MST-MRDT/Motor-Controller/Documentation/2020 BOM/MotorController_Hardware_2020_Rev1_BOM.csv

Id | Designator | Package | Quantity | Designation | Supplier and ref
1 | G*** | Zenith_Logo_30mm | 1 | LOGO
2 | G*** | Wifi_Power_Net_5mmX6mm | 1 | LOGO
3 | REF**,REF**,REF**,REF** | 4_40_Hole_Corner | 4 | 4_40_Hole
4 | U1 | DRV8301 | 1 | DRV8301 | https://www.digikey.com/products/en?keywords=296-29433-1-ND | https://www.newark.com/texas-instruments/drv8301dcar/motor-driver-3ph-56htssop/dp/28AH2478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
5 | C1,C4,C10,C13,C15,C18,C19,C20,C21,C33,C34,C35,C40,C41,C42,C43,C44 | C_0603_1608Metric_Pad1.05x0.95mm_HandSolder | 17 | 0.1u | https://www.newark.com/avx/06035c104jat2a/ceramic-capacitor-0-1uf-50v-x7r/dp/60R6235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
6 | C2,C8 | C_0603_1608Metric_Pad1.05x0.95mm_HandSolder | 2 | 4.7u | https://www.digikey.com/products/en?keywords=490-10751-1-ND
7 | C3,C26,C27 | C_0603_1608Metric_Pad1.05x0.95mm_HandSolder | 3 | 1u | https://www.newark.com/avx/06035c104jat2a/ceramic-capacitor-0-1uf-50v-x7r/dp/60R6235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
8 | C5,C7,C9,C11 | CP_Radial_D12.5mm_P5.00mm | 4 | 470u | https://www.newark.com/panasonic/eca-1jhg471/aluminum-electrolytic-capacitor/dp/96K9189
9 | C6 | CP_Radial_D6.3mm_P2.50mm | 1 | 47u | https://www.newark.com/panasonic/eca-1hm470/aluminum-electrolytic-capacitor/dp/96K9182
10 | C12,C14 | C_0603_1608Metric_Pad1.05x0.95mm_HandSolder | 2 | 2200p | https://www.newark.com/kemet/c0603c222k5ractu/ceramic-capacitor-2200pf-50v-x7r/dp/64K2852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
11 | C16 | C_0603_1608Metric_Pad1.05x0.95mm_HandSolder | 1 | 0.01u | https://www.newark.com/tdk/cga3e2x7r1h103k080ae/cap-0-01-f-50v-10-x7r-0603/dp/68AC4563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
12 | C17 | C_0603_1608Metric_Pad1.05x0.95mm_HandSolder | 1 | .022u | https://www.newark.com/vishay/vj0603y223jxacw1bc/cap-0-022-f-50v-5-x7r-0603/dp/62AC8374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
13 | C22 | C_0603_1608Metric_Pad1.05x0.95mm_HandSolder | 1 | 0.015u | https://www.newark.com/vishay/vj0603y153kxacw1bc/cap-0-015-f-50v-10-x7r-0603/dp/62AC8368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
14 | C23 | C_0603_1608Metric_Pad1.05x0.95mm_HandSolder | 1 | 120p | https://www.newark.com/avx/06035a121jat2a/ceramic-capacitor-120pf-50v-c0g/dp/17C6469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
15 | C24 | C_0603_1608Metric_Pad1.05x0.95mm_HandSolder | 1 | 6800p | https://www.newark.com/kemet/c0603c682j5gactu/cap-mlcc-c0g-6800pf-50v-0603/dp/72M7462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
16 | C25,C30,C31,C32 | C_0603_1608Metric_Pad1.05x0.95mm_HandSolder | 4 | 2.2u | https://www.newark.com/taiyo-yuden/umk107bbj225ka-t/capacitor-mlcc-0603-50v-x5r-2/dp/08AH2222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
17 | C28,C29 | C_0603_1608Metric_Pad1.05x0.95mm_HandSolder | 2 | 1000p | https://www.newark.com/avx/06035c102kat2a/ceramic-capacitor-1000pf-50v-x7r/dp/09J2480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
18 | C36 | C_0603_1608Metric_Pad1.05x0.95mm_HandSolder | 1 | .015 uF | https://www.newark.com/vishay/vj0603y153kxacw1bc/cap-0-015-f-50v-10-x7r-0603/dp/62AC8368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
19 | Conn1 | MOLEX_SL_05_Horizontal | 1 | Molex_SL_05
20 | Conn3 | Anderson_2_Horizontal_Stacked | 1 | AndersonPP
21 | Conn4 | Anderson_1_Horizontal | 1 | SH_A_M1_PP
22 | Conn5 | Anderson_1_Horizontal | 1 | SH_B_M1_PP
23 | Conn6 | Anderson_1_Horizontal | 1 | SH_C_M1_PP
24 | D2,D3,D4,D5 | L_0603_1608Metric_Pad1.05x0.95mm_HandSolder | 4 | LED | https://www.newark.com/vishay/vlmg1300-gs08/led-yellow-green-571nm/dp/76T8664?st=0603%20green%20LED
25 | D7,D8,D9,D10,D11,D12 | D_SOD-123 | 6 | 15V | https://www.newark.com/on-semiconductor/mmsz4684t1g/zener-diode-500mw-3-3v-sod-123/dp/45J1578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
26 | L1 | DR74_330_R | 1 | 33u | https://www.newark.com/eaton-coiltronics/dr74-330-r/inductor-shielded-33uh-1-73a-smd/dp/52K7577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
27 | Q1,Q2 | SOT-23_Handsoldering | 2 | Q_PMOS_DGS | https://www.digikey.com/products/en?keywords=SSM3J338RLFCT-ND
28 | Q4,Q5,Q6,Q7,Q8,Q9 | TO-220-3_Horizontal_Reversed_NoHole | 6 | FQP30N06L | https://www.digikey.com/products/en?keywords=FQP30N06L
29 | R1,R2,R3,R5 | R_0603_1608Metric_Pad1.05x0.95mm_HandSolder | 4 | 10k | https://www.newark.com/multicomp/mcwr06x1002ftl/surface-mount-thick-film-resistor/dp/94X1379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
30 | R4 | R_0603_1608Metric_Pad1.05x0.95mm_HandSolder | 1 | 31.6k | https://www.newark.com/vishay/crcw040231k6fked/res-thick-film-31k6-1-0-063w-0402/dp/52K6966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
31 | R6,R8 | R_0603_1608Metric_Pad1.05x0.95mm_HandSolder | 2 | 1k | https://www.newark.com/vishay/crcw06031k00fkea/res-thick-film-1k-1-0-1w-0603/dp/52K8016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
32 | R7 | R_0603_1608Metric_Pad1.05x0.95mm_HandSolder | 1 | 100 | https://www.newark.com/yageo/rc0603fr-07100rl/res-thick-film-100r-1-0-1w-0603/dp/68R0052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
33 | R9 | R_0603_1608Metric_Pad1.05x0.95mm_HandSolder | 1 | 510 | https://www.newark.com/vishay/crcw0603510rfkea/res-thick-film-510r-1-0-1w-0603/dp/52K8597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
34 | R10,R13 | R_0603_1608Metric_Pad1.05x0.95mm_HandSolder | 2 | 500 | https://www.newark.com/vishay/crcw0603510rfkea/res-thick-film-510r-1-0-1w-0603/dp/52K8597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
35 | R11,R12 | R_0603_1608Metric_Pad1.05x0.95mm_HandSolder | 2 | 56 | https://www.newark.com/vishay/crcw060356r0jnea/res-thick-film-56r-5-0-1w-0603/dp/59M6825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
36 | R14 | R_1206_3216Metric_Pad1.42x1.75mm_HandSolder | 1 | 3.3 | https://www.newark.com/vishay/crcw12063r30jnea/res-thick-film-3r3-5-0-25w-1206/dp/59M6979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
37 | R15,R30,R32,R34 | R_0603_1608Metric_Pad1.05x0.95mm_HandSolder | 4 | 46.4k | https://www.digikey.com/product-detail/en/yageo/RT0603BRD0746K4L/YAG1665CT-ND/5139113
38 | R16,R31,R33,R35 | R_0603_1608Metric_Pad1.05x0.95mm_HandSolder | 4 | 4.99k | https://www.digikey.com/product-detail/en/yageo/RT0603BRD074K99L/YAG1678CT-ND/5139126
39 | R18 | R_0603_1608Metric_Pad1.05x0.95mm_HandSolder | 1 | 205k | https://www.newark.com/vishay/crcw0603205kfkea/res-thick-film-205k-1-0-1w-0603/dp/52K8275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
40 | R19 | R_0603_1608Metric_Pad1.05x0.95mm_HandSolder | 1 | 150k | https://www.newark.com/panasonic/erj-3ekf1503v/res-thick-film-150k-1-0-1w-0603/dp/64R5321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
41 | R20 | R_0603_1608Metric_Pad1.05x0.95mm_HandSolder | 1 | 16.2k | https://www.newark.com/panasonic/erj-3ekf1622v/res-thick-film-16k2-1-0-1w-0603/dp/65T8345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
42 | R22,R23,R24,R25,R26,R27 | R_0603_1608Metric_Pad1.05x0.95mm_HandSolder | 6 | 10 | https://www.newark.com/vishay/crcw060310r0fkeahp/res-aec-q200-10r-1-0-25w-0603/dp/65AC3377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
43 | R28,R29 | R_1206_3216Metric_Pad1.42x1.75mm_HandSolder | 2 | 0.001 | https://www.digikey.com/product-detail/en/stackpole-electronics-inc/CSNL1206FT1L00/CSNL1206FT1L00CT-ND/1788120
44 | U2 | NUP4201MR6 | 1 | NUP4201MR6 | https://www.digikey.com/product-detail/en/diodes-incorporated/D5V0P4UR6SO-7/D5V0P4UR6SO-7DICT-ND/6052574
45 | U4 | SOIC_16_3.9x9.9mm_Pitch1.27mm | 1 | MAX_3232 | https://www.digikey.com/product-detail/en/texas-instruments/MAX3232CDR/296-13094-1-ND/484464
46 | +3V3,GHB_M1,GHC_M1,GLA_M1,GLB_M1,GLC_M1,PVDD_M1,SHA_M1,SHB_M1,SHC_M1 | Via_.6mm | 10 | TEST
47 | GHA_M1 | Via_.6mm | 1 | tp
48 | D1 | D_0603_1608Metric_Pad1.05x0.95mm_HandSolder | 1 | D_Zener
49 | R17,R21 | R_0603_1608Metric_Pad1.05x0.95mm_HandSolder | 2 | 0 | https://www.newark.com/vishay/crcw06030000z0eahp/res-thick-film-0r-0-25w-0603/dp/68R2987
50 | U3 | F28027M_THT_TOP | 1 | F28027M
51 | R36 | R_0603_1608Metric_Pad1.05x0.95mm_HandSolder | 1 | 1000 | https://www.newark.com/vishay/crcw06031k00fkea/surface-mount-thick-film-resistor/dp/61M5328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
