MST-MRDT/Motor-Controller/MotorController_Hardware/MotorController_Hardware.kicad_pcb

## KiCad design MotorController_Hardware/MotorController_Hardware.kicad_pcb (2019-11-07)

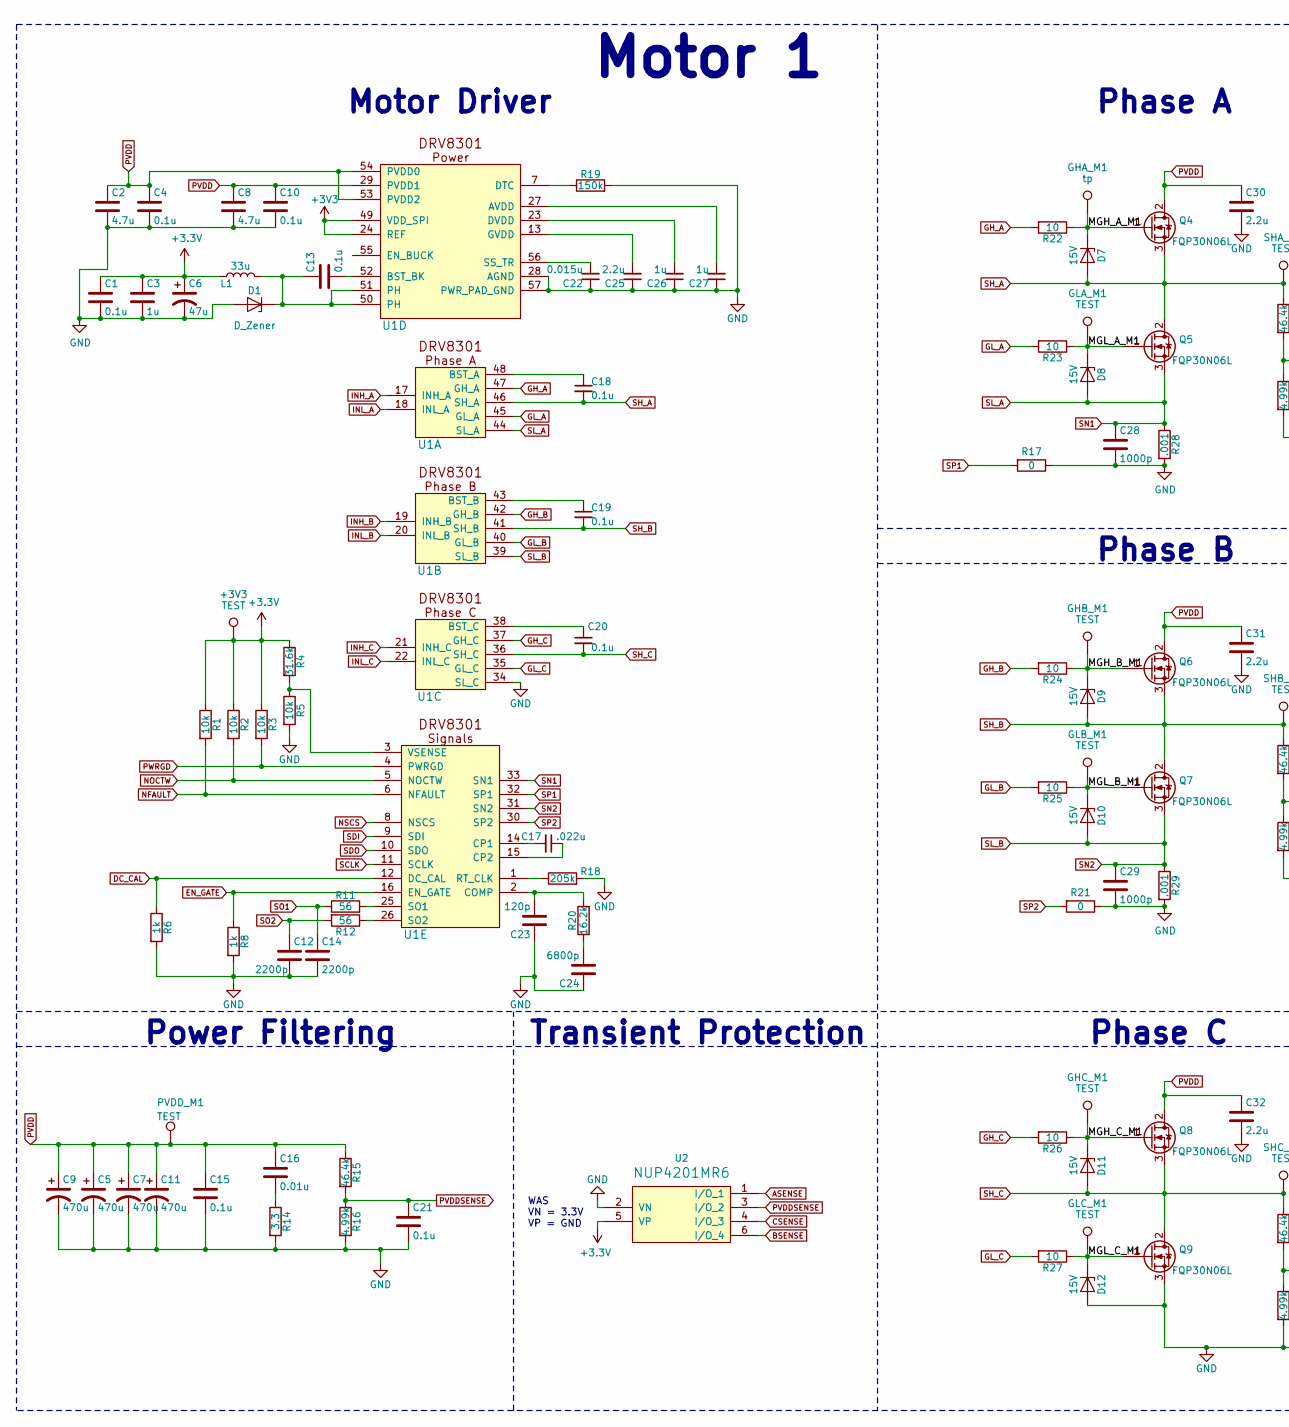
[picture p1: schematic MotorController_Hardware.sch, part in row 1, column 1]

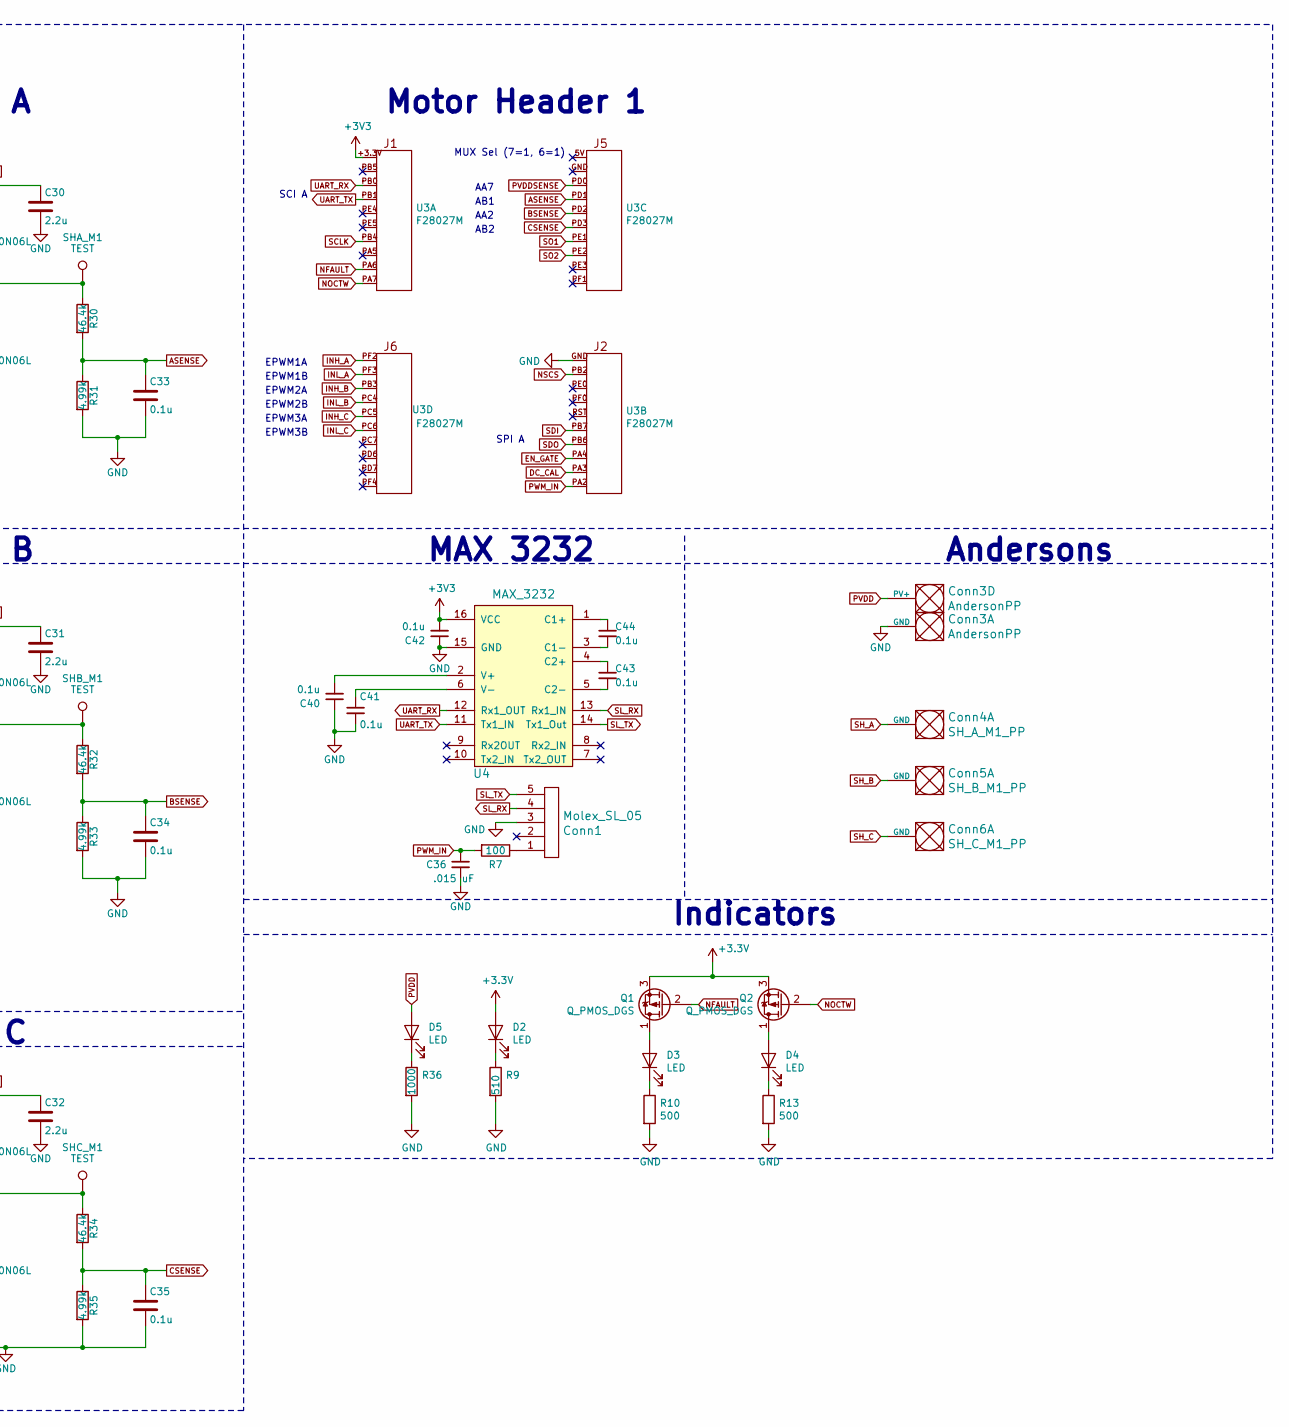
[picture p2: schematic MotorController_Hardware.sch, part in row 1, column 2]

Parts:
+3V3: TEST; Via_.6mm
C1, C4, C10, C13, C15, C18, C19, C20, C21, C33, C34, C35, C40, C41, C42, C43, C44: 0.1u; C_0603_1608Metric_Pad1.05x0.95mm_HandSolder
C2, C8: 4.7u; C_0603_1608Metric_Pad1.05x0.95mm_HandSolder
C3, C26, C27: 1u; C_0603_1608Metric_Pad1.05x0.95mm_HandSolder
C5, C7, C9, C11: 470u; CP_Radial_D12.5mm_P5.00mm
C6: 47u; CP_Radial_D6.3mm_P2.50mm
C12, C14: 2200p; C_0603_1608Metric_Pad1.05x0.95mm_HandSolder
C16: 0.01u; C_0603_1608Metric_Pad1.05x0.95mm_HandSolder
C17: .022u; C_0603_1608Metric_Pad1.05x0.95mm_HandSolder
C22: 0.015u; C_0603_1608Metric_Pad1.05x0.95mm_HandSolder
C23: 120p; C_0603_1608Metric_Pad1.05x0.95mm_HandSolder
C24: 6800p; C_0603_1608Metric_Pad1.05x0.95mm_HandSolder
C25, C30, C31, C32: 2.2u; C_0603_1608Metric_Pad1.05x0.95mm_HandSolder
C28, C29: 1000p; C_0603_1608Metric_Pad1.05x0.95mm_HandSolder
C36: .015 uF; C_0603_1608Metric_Pad1.05x0.95mm_HandSolder
Conn1: Molex_SL_05; MOLEX_SL_05_Horizontal
Conn3: AndersonPP; Anderson_2_Horizontal_Stacked
Conn4: SH_A_M1_PP; Anderson_1_Horizontal
Conn5: SH_B_M1_PP; Anderson_1_Horizontal
Conn6: SH_C_M1_PP; Anderson_1_Horizontal
D1: D_Zener; D_0603_1608Metric_Pad1.05x0.95mm_HandSolder
D2, D3, D4, D5: LED; L_0603_1608Metric_Pad1.05x0.95mm_HandSolder
D7, D8, D9, D10, D11, D12: 15V; D_SOD-123
GHA_M1: tp; Via_.6mm
GHB_M1: TEST; Via_.6mm
GHC_M1: TEST; Via_.6mm
GLA_M1: TEST; Via_.6mm
GLB_M1: TEST; Via_.6mm
GLC_M1: TEST; Via_.6mm
L1: 33u; DR74_330_R
PVDD_M1: TEST; Via_.6mm
Q1, Q2: Q_PMOS_DGS; SOT-23_Handsoldering
Q4, Q5, Q6, Q7, Q8, Q9: FQP30N06L; TO-220-3_Horizontal_Reversed_NoHole
R1, R2, R3, R5: 10k; R_0603_1608Metric_Pad1.05x0.95mm_HandSolder
R4: 31.6k; R_0603_1608Metric_Pad1.05x0.95mm_HandSolder
R6, R8: 1k; R_0603_1608Metric_Pad1.05x0.95mm_HandSolder
R7: 100; R_0603_1608Metric_Pad1.05x0.95mm_HandSolder
R9: 510; R_0603_1608Metric_Pad1.05x0.95mm_HandSolder
R10, R13: 500; R_0603_1608Metric_Pad1.05x0.95mm_HandSolder
R11, R12: 56; R_0603_1608Metric_Pad1.05x0.95mm_HandSolder
R14: 3.3; R_1206_3216Metric_Pad1.42x1.75mm_HandSolder
R15, R30, R32, R34: 46.4k; R_0603_1608Metric_Pad1.05x0.95mm_HandSolder
R16, R31, R33, R35: 4.99k; R_0603_1608Metric_Pad1.05x0.95mm_HandSolder
R17, R21: 0; R_0603_1608Metric_Pad1.05x0.95mm_HandSolder
R18: 205k; R_0603_1608Metric_Pad1.05x0.95mm_HandSolder
R19: 150k; R_0603_1608Metric_Pad1.05x0.95mm_HandSolder
R20: 16.2k; R_0603_1608Metric_Pad1.05x0.95mm_HandSolder
R22, R23, R24, R25, R26, R27: 10; R_0603_1608Metric_Pad1.05x0.95mm_HandSolder
R28, R29: .001; R_1206_3216Metric_Pad1.42x1.75mm_HandSolder
R36: 1000; R_0603_1608Metric_Pad1.05x0.95mm_HandSolder
SHA_M1: TEST; Via_.6mm
SHB_M1: TEST; Via_.6mm
SHC_M1: TEST; Via_.6mm
U1: DRV8301
U2: NUP4201MR6
U3: F28027M; F28027M_THT_TOP
U4: MAX_3232; SOIC_16_3.9x9.9mm_Pitch1.27mm

Connections:
/MGH_A_M1: D7.1 (K), GHA_M1.1, Q4.1 (G), R22.1
/MGH_B_M1: D9.1 (K), GHB_M1.1, Q6.1 (G), R24.1
/MGH_C_M1: D11.1 (K), GHC_M1.1, Q8.1 (G), R26.1
/MGL_A_M1: D8.1 (K), GLA_M1.1, Q5.1 (G), R23.1
/MGL_B_M1: D10.1 (K), GLB_M1.1, Q7.1 (G), R25.1
/MGL_C_M1: D12.1 (K), GLC_M1.1, Q9.1 (G), R27.1
ASENSE: C33.1, R30.2, R31.1, U2.1 (I/O_1), U3.PD1
BSENSE: C34.1, R32.2, R33.1, U2.6 (I/O_4), U3.PD2
CSENSE: C35.1, R34.2, R35.1, U2.4 (I/O_3), U3.PD3
DC_CAL: R6.1, U1.12 (DC_CAL), U3.PA3
EN_GATE: R8.1, U1.16 (EN_GATE), U3.PA4
GH_A: R22.2, U1.47 (GH_A)
GH_B: R24.2, U1.42 (GH_B)
GH_C: R26.2, U1.37 (GH_C)
GL_A: R23.2, U1.45 (GL_A)
GL_B: R25.2, U1.40 (GL_B)
GL_C: R27.2, U1.35 (GL_C)
INH_A: U1.17 (INH_A), U3.PF2
INH_B: U1.19 (INH_B), U3.PB3
INH_C: U1.21 (INH_C), U3.PC5
INL_A: U1.18 (INL_A), U3.PF3
INL_B: U1.20 (INL_B), U3.PC4
INL_C: U1.22 (INL_C), U3.PC6
NFAULT: Q1.2 (G), R1.2, U1.6 (NFAULT), U3.PA6
NOCTW: Q2.2 (G), R2.2, U1.5 (NOCTW), U3.PA7
NSCS: U1.8 (NSCS), U3.PB2
unnamed: C13.1, D1.1 (K), L1.2, U1.50 (PH), U1.51 (PH)
unnamed: C13.2, U1.52 (BST_BK)
unnamed: C16.2, R14.1
unnamed: C17.1, U1.15 (CP2)
unnamed: C17.2, U1.14 (CP1)
unnamed: C18.1, U1.48 (BST_A)
unnamed: C19.1, U1.43 (BST_B)
unnamed: C20.1, U1.38 (BST_C)
unnamed: C22.2, U1.56 (SS_TR)
unnamed: C23.2, R20.2, U1.2 (COMP)
unnamed: C24.2, R20.1
unnamed: C25.2, U1.13 (GVDD)
unnamed: C26.2, U1.23 (DVDD)
unnamed: C27.2, U1.27 (AVDD)
unnamed: C40.2, U4.2 (V+)
unnamed: C41.1, U4.6 (V-)
unnamed: C43.1, U4.4 (C2+)
unnamed: C43.2, U4.5 (C2-)
unnamed: C44.1, U4.1 (C1+)
unnamed: C44.2, U4.3 (C1-)
unnamed: Conn1.1, R7.1
unnamed: D2.1 (K), R9.1
unnamed: D3.1 (K), R10.1
unnamed: D3.2 (A), Q1.1 (D)
unnamed: D4.1 (K), R13.1
unnamed: D4.2 (A), Q2.1 (D)
unnamed: D5.1 (K), R36.1
unnamed: R4.2, R5.1, U1.3 (VSENSE)
unnamed: R11.2, U1.25 (SO1)
unnamed: R12.1, U1.26 (SO2)
unnamed: R18.1, U1.1 (RT_CLK)
unnamed: R19.1, U1.7 (DTC)
PVDD: C2.1, C4.1, C5.1, C7.1, C8.1, C9.1, C10.1, C11.1, C15.1, C16.1, C30.1, C31.1, C32.1, Conn3.4 (PV+), D5.2 (A), PVDD_M1.1, Q4.2 (D), Q6.2 (D), Q8.2 (D), R15.1, U1.29 (PVDD1), U1.53 (PVDD2), U1.54 (PVDD0)
PVDDSENSE: C21.1, R15.2, R16.1, U2.3 (I/O_2), U3.PD0
PWM_IN: C36.1, R7.2, U3.PA2
PWRGD: R3.2, U1.4 (PWRGD)
SCLK: U1.11 (SCLK), U3.PB4
SDI: U1.9 (SDI), U3.PB7
SDO: U1.10 (SDO), U3.PB6
SH_A: C18.2, Conn4.1 (GND), D7.2 (A), Q4.3 (S), Q5.2 (D), R30.1, SHA_M1.1, U1.46 (SH_A)
SH_B: C19.2, Conn5.1 (GND), D9.2 (A), Q6.3 (S), Q7.2 (D), R32.1, SHB_M1.1, U1.41 (SH_B)
SH_C: C20.2, Conn6.1 (GND), D11.2 (A), Q8.3 (S), Q9.2 (D), R34.1, SHC_M1.1, U1.36 (SH_C)
SL_A: C28.1, D8.2 (A), Q5.3 (S), R28.1, U1.33 (SN1), U1.44 (SL_A)
SL_B: C29.1, D10.2 (A), Q7.3 (S), R29.1, U1.31 (SN2), U1.39 (SL_B)
SL_RX: Conn1.4, U4.13 (Rx1_IN)
SL_TX: Conn1.5, U4.14 (Tx1_Out)
SO1: C14.1, R11.1, U3.PE1
SO2: C12.1, R12.2, U3.PE2
SP1: R17.2, U1.32 (SP1)
SP2: R21.2, U1.30 (SP2)
UART_RX: U3.PB0, U4.12 (Rx1_OUT)
UART_TX: U3.PB1, U4.11 (Tx1_IN)

Notes on the sheet:
Power Filtering
Transient Protection
Motor Driver
Phase A
Phase B
Phase C
Indicators
MAX 3232
Motor Header 1
Motor 1
Andersons
MUX Sel (7=1, 6=1)
AA7
AB1
AA2
AB2
SCI A
SPI A
EPWM3B
EPWM3A
EPWM2B
EPWM2A
EPWM1B
EPWM1A
WAS VN = 3.3V VP = GND

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
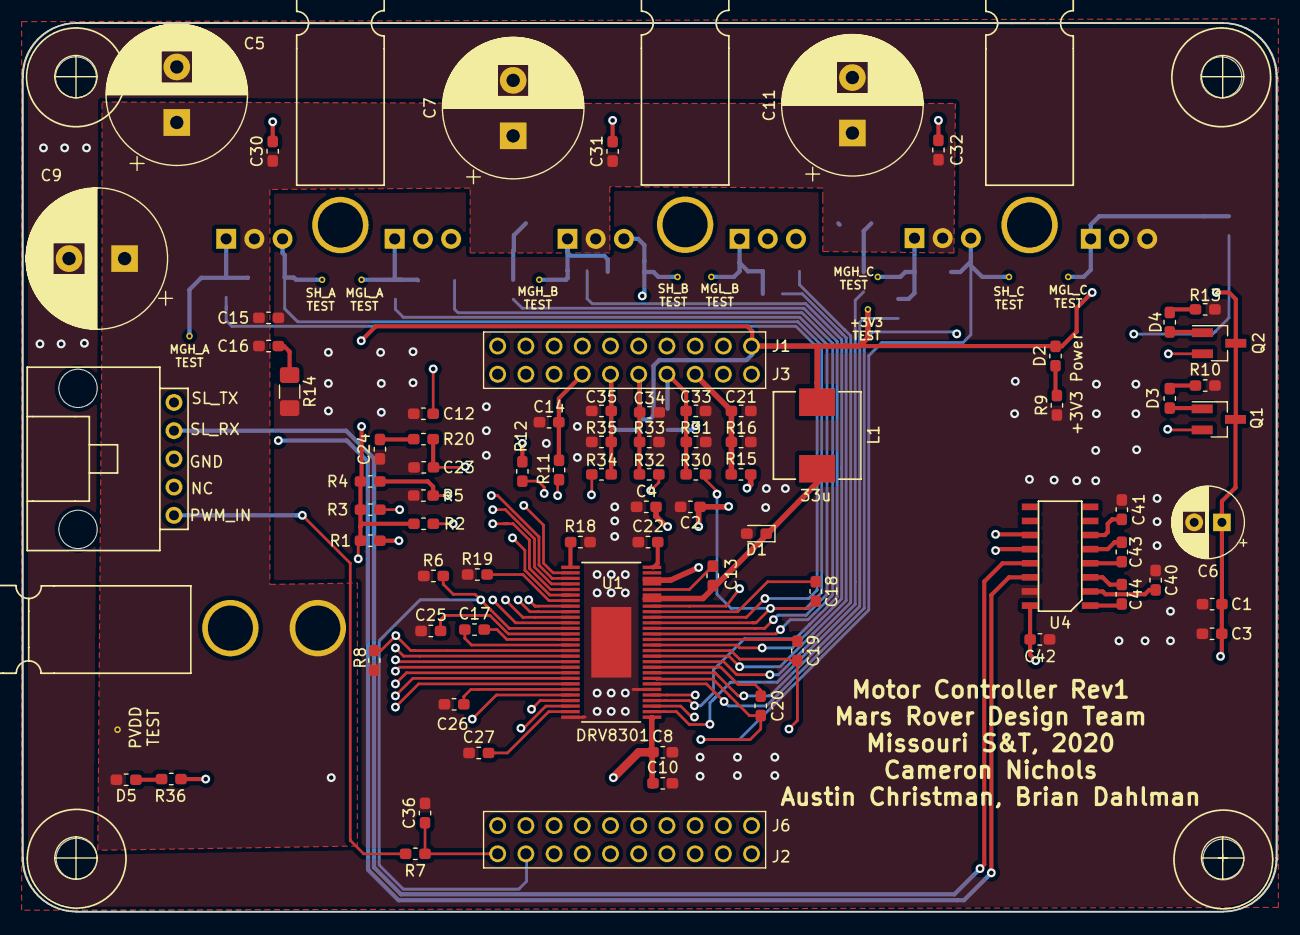
[picture p3: board MotorController_Hardware.kicad_pcb from above]

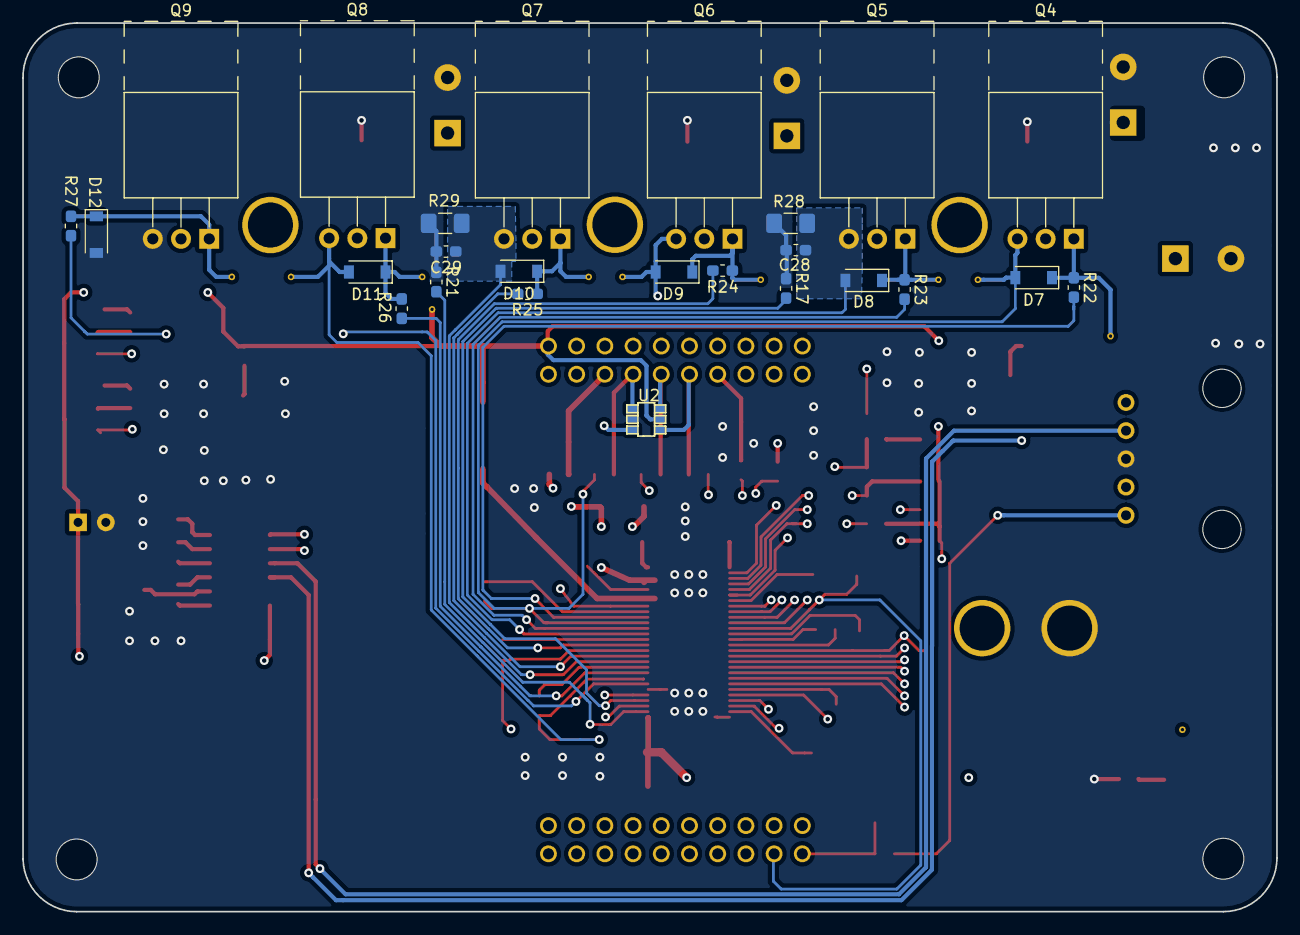
[picture p4: board MotorController_Hardware.kicad_pcb from below]

Board: 4 copper layers, 112.9 x 80.0 mm, 117 parts (25 on the bottom side), 80 nets.
