MST-MRDT/Motor-Controller/(commit log)

2019-09-30 Schematic finished and footprints assigned
    [MotorController_Hardware.kicad_pcb]
2019-10-05 high level layout
    [MotorController_Hardware.kicad_pcb, MotorController_Hardware.sch]
2019-10-05 PCB layout: In progress
    [MotorController_Hardware.kicad_pcb]
2019-10-11 Work done on PCB layout
    [MotorController_Hardware.kicad_pcb, MotorController_Hardware.sch]
2019-10-13 Finished PCB layout
    [MotorController_Hardware.kicad_pcb, MotorController_Hardware.sch]
2019-10-13 Silkscreens added
    [MotorController_Hardware.kicad_pcb, MotorController_Hardware.sch]
2019-10-20 WORKING ON ORDERING
    [MotorController_Hardware-B_Cu.gbr, MotorController_Hardware-B_Mask.gbr, MotorController_Hardware-B_Paste.gbr, MotorController_Hardware-B_SilkS.gbr, MotorController_Hardware-Edge_Cuts.gbr, MotorController_Hardware-F_Cu.gbr, MotorController_Hardware-F_Mask.gbr, MotorController_Hardware-F_Paste.gbr]
2019-11-07 BOM update
    [MotorController_Hardware-B_Cu.gbr, MotorController_Hardware-B_Mask.gbr, MotorController_Hardware-B_Paste.gbr, MotorController_Hardware-B_SilkS.gbr, MotorController_Hardware-Edge_Cuts.gbr, MotorController_Hardware-F_Cu.gbr, MotorController_Hardware-F_Mask.gbr, MotorController_Hardware-F_Paste.gbr]
